danja/mini-draw/images/arms-template_2021-03-11.pdf

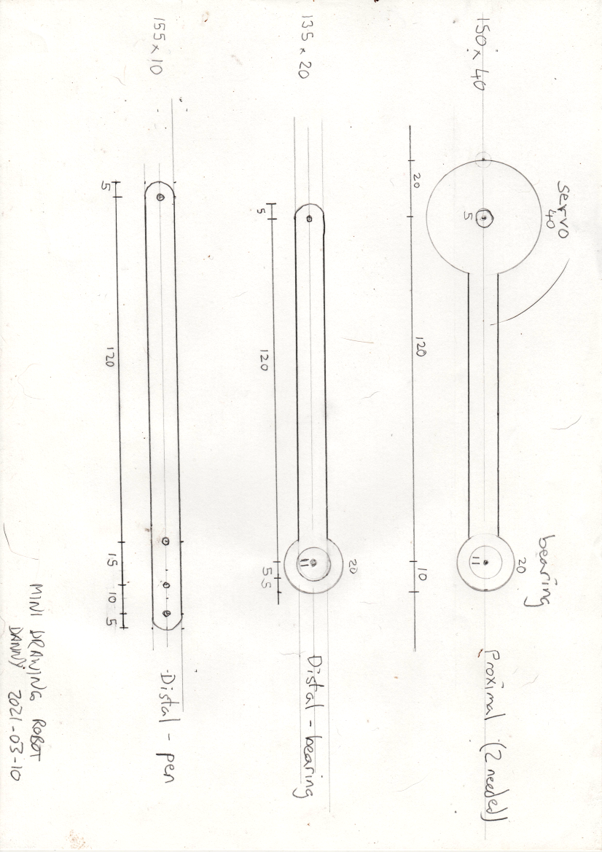
[picture p11: page 1]
