danja/mini-draw/images/first drawing.jpeg

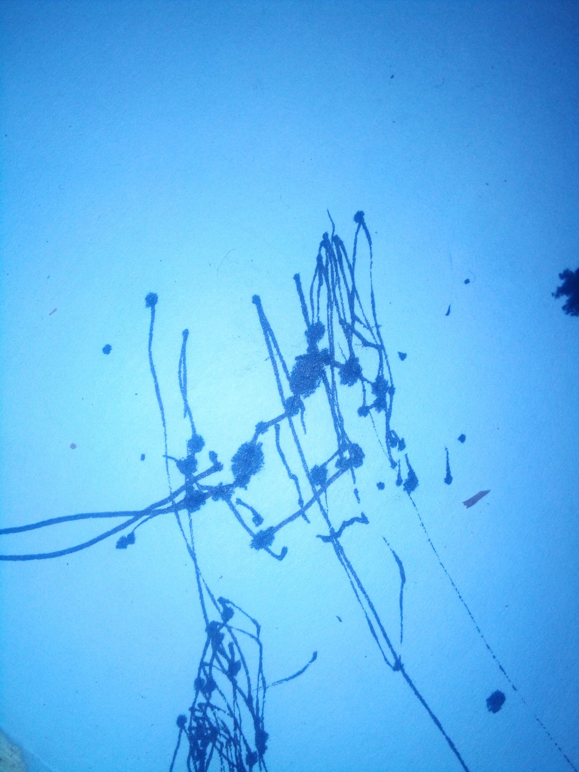
images/first drawing.jpeg
