danja/mini-draw/images/five-bar-gate.JPG

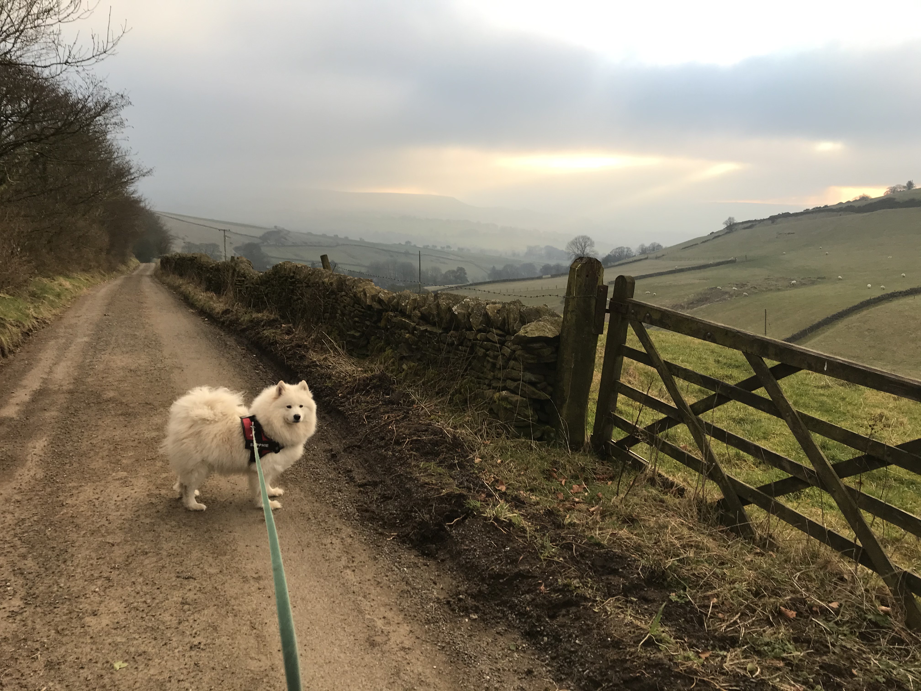
images/five-bar-gate.JPG
