danja/mini-draw/images/five-bar.png

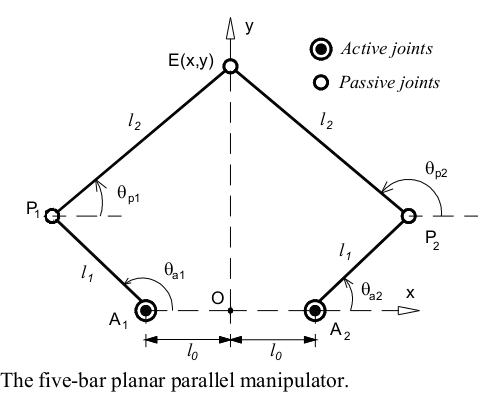
images/five-bar.png
