danja/mini-draw/images/legs.png

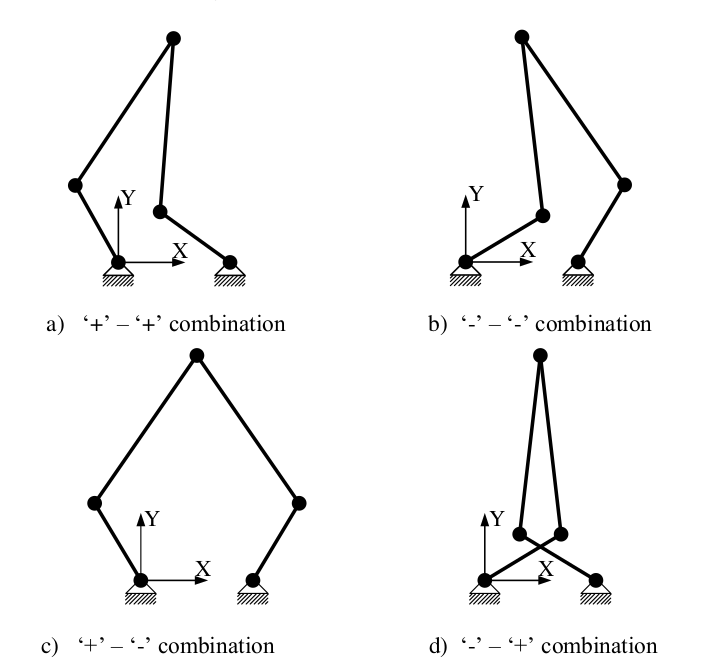
images/legs.png
