danja/mini-draw/images/overview2.jpeg

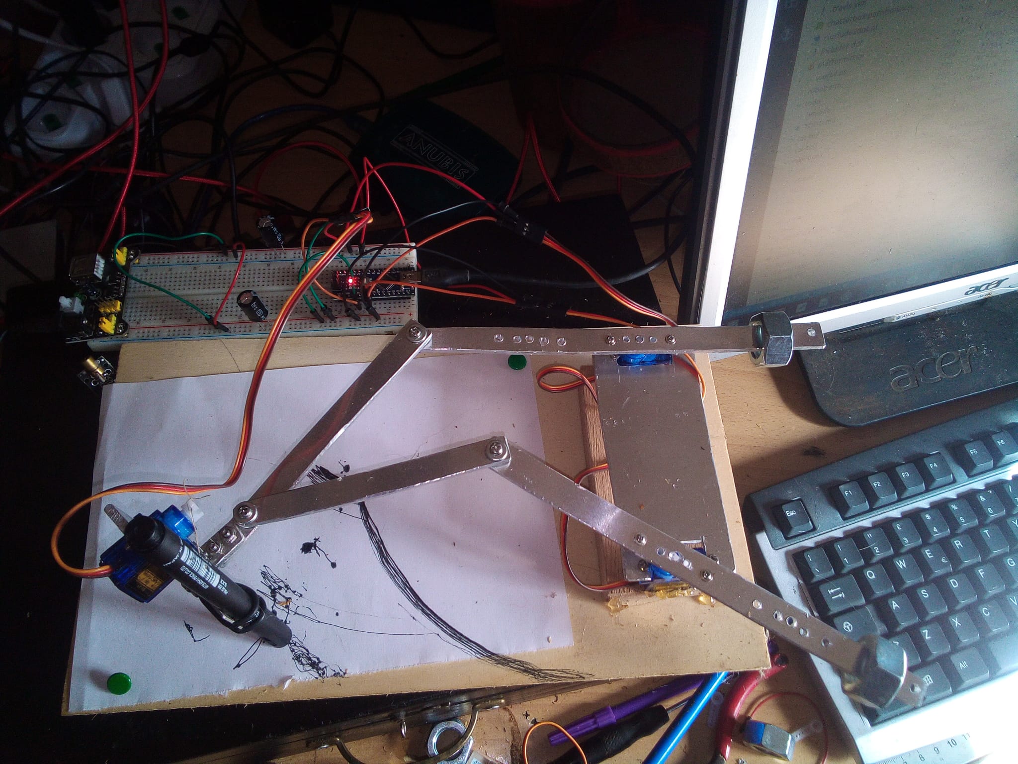
images/overview2.jpeg
