danja/mini-draw/images/pen-lifter.jpeg

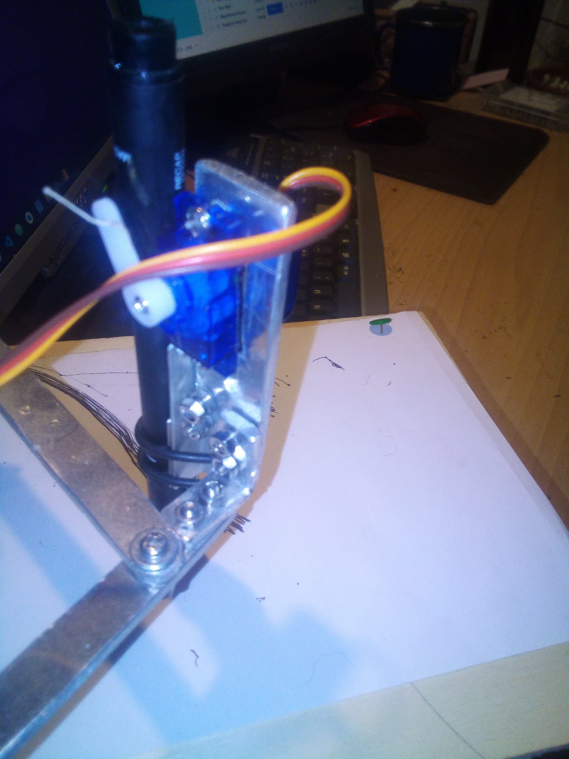
images/pen-lifter.jpeg
