danja/mini-draw/images/Screenshot from 2021-03-04 22-04-25.png

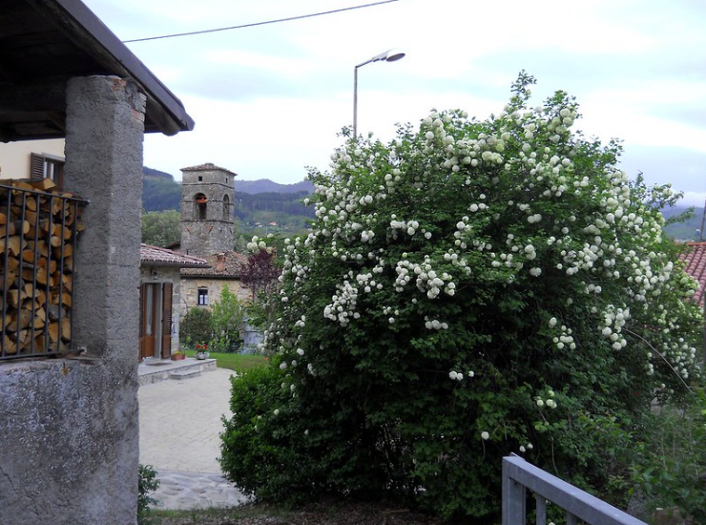
images/Screenshot from 2021-03-04 22-04-25.png
