danja/mini-draw/images/servo.jpeg

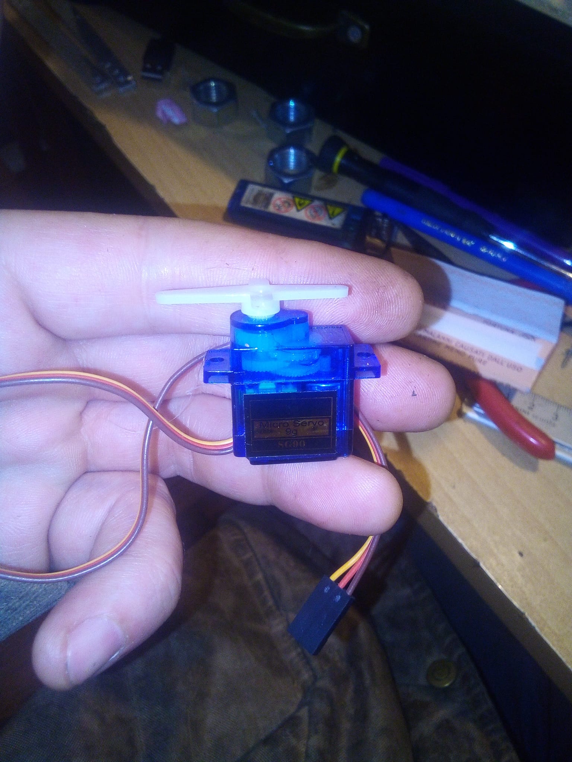
images/servo.jpeg
