danja/mini-draw/images/top-view-annotated.jpeg

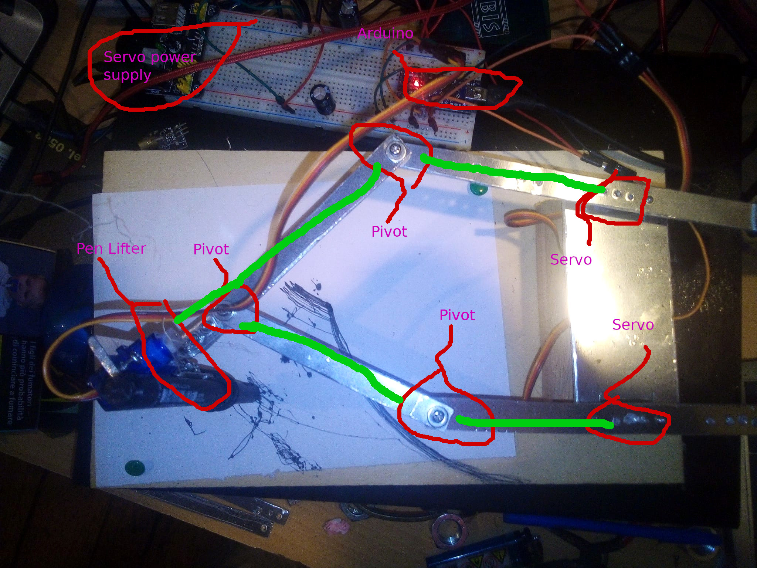
images/top-view-annotated.jpeg
