danja/mini-draw/references/parallel_scara_stylus.jpeg

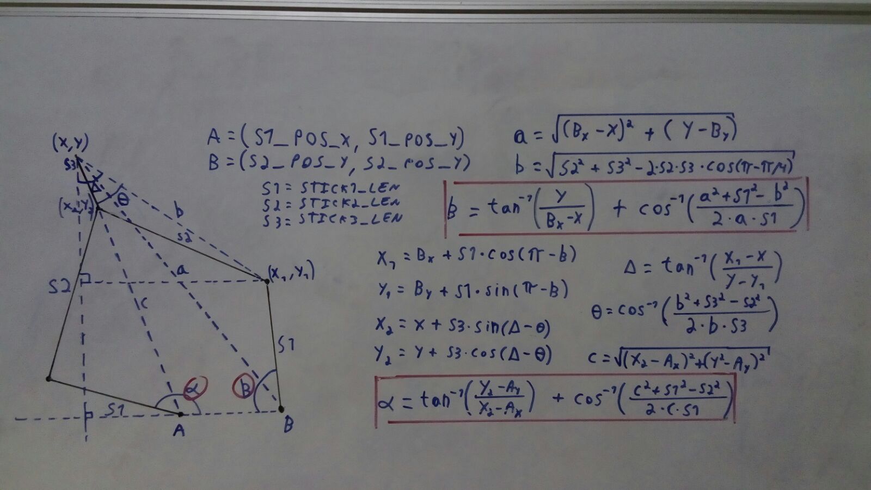
references/parallel_scara_stylus.jpeg
