danja/mini-draw/(commit log)

2021-02-26 added early pics, reference material
2021-02-28 forward kinematicssimulation mostly working
2021-03-01 added precision forward kinematics simulation
2021-03-11 working on prototype v2
